crls-design/Flight-Controller/docs/schematic.pdf

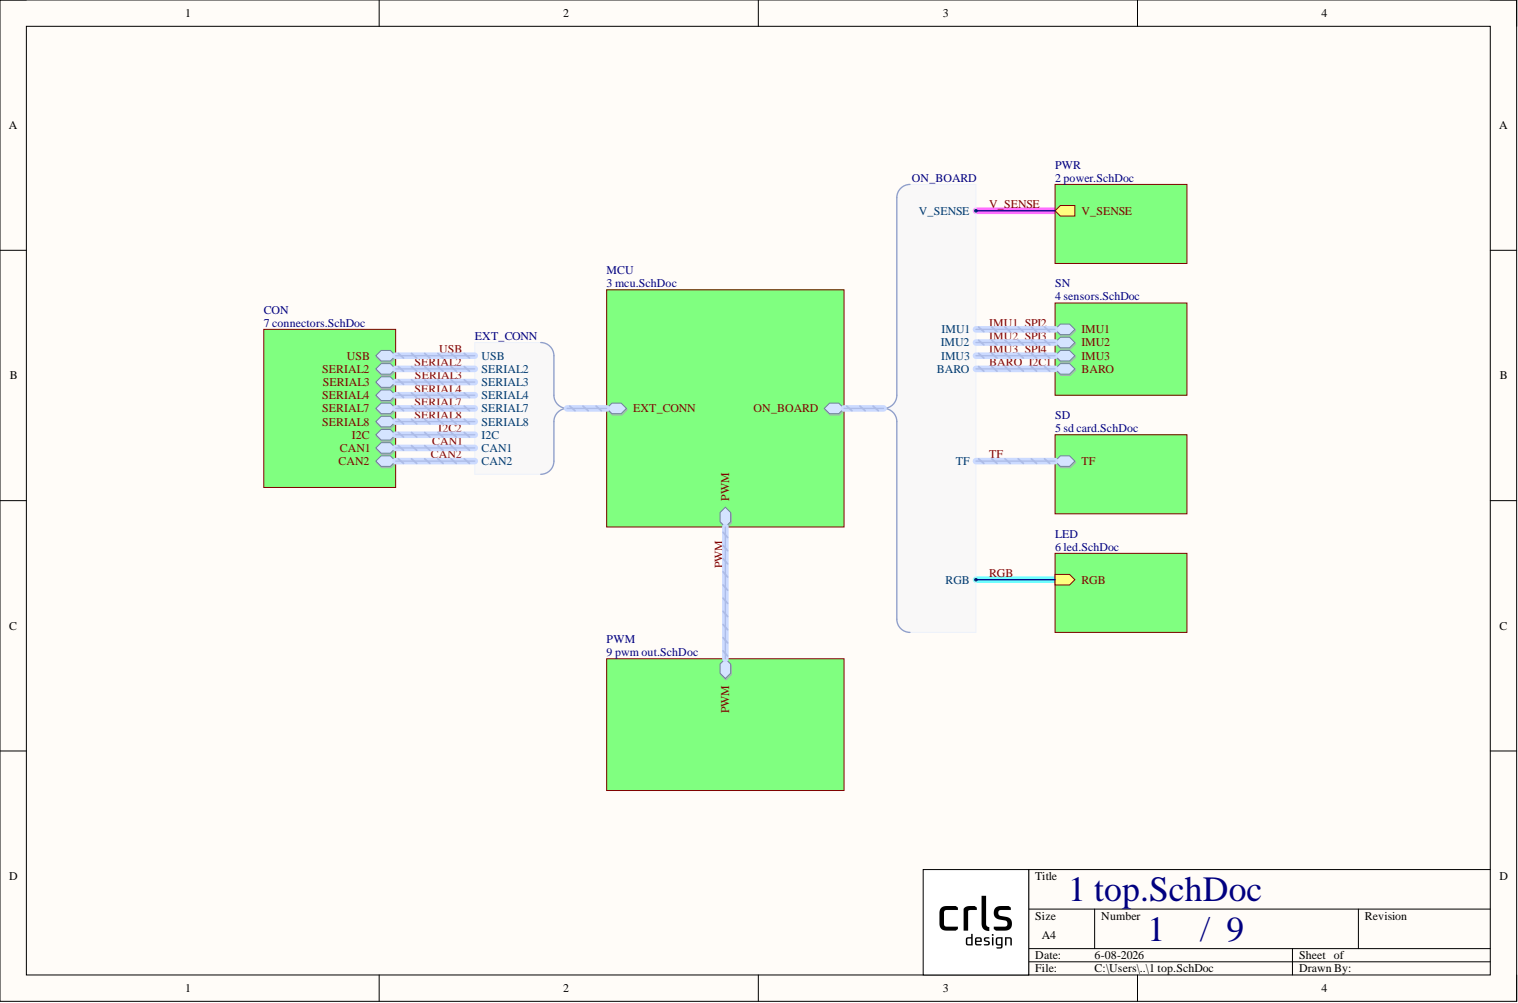
[picture p2: page 1]

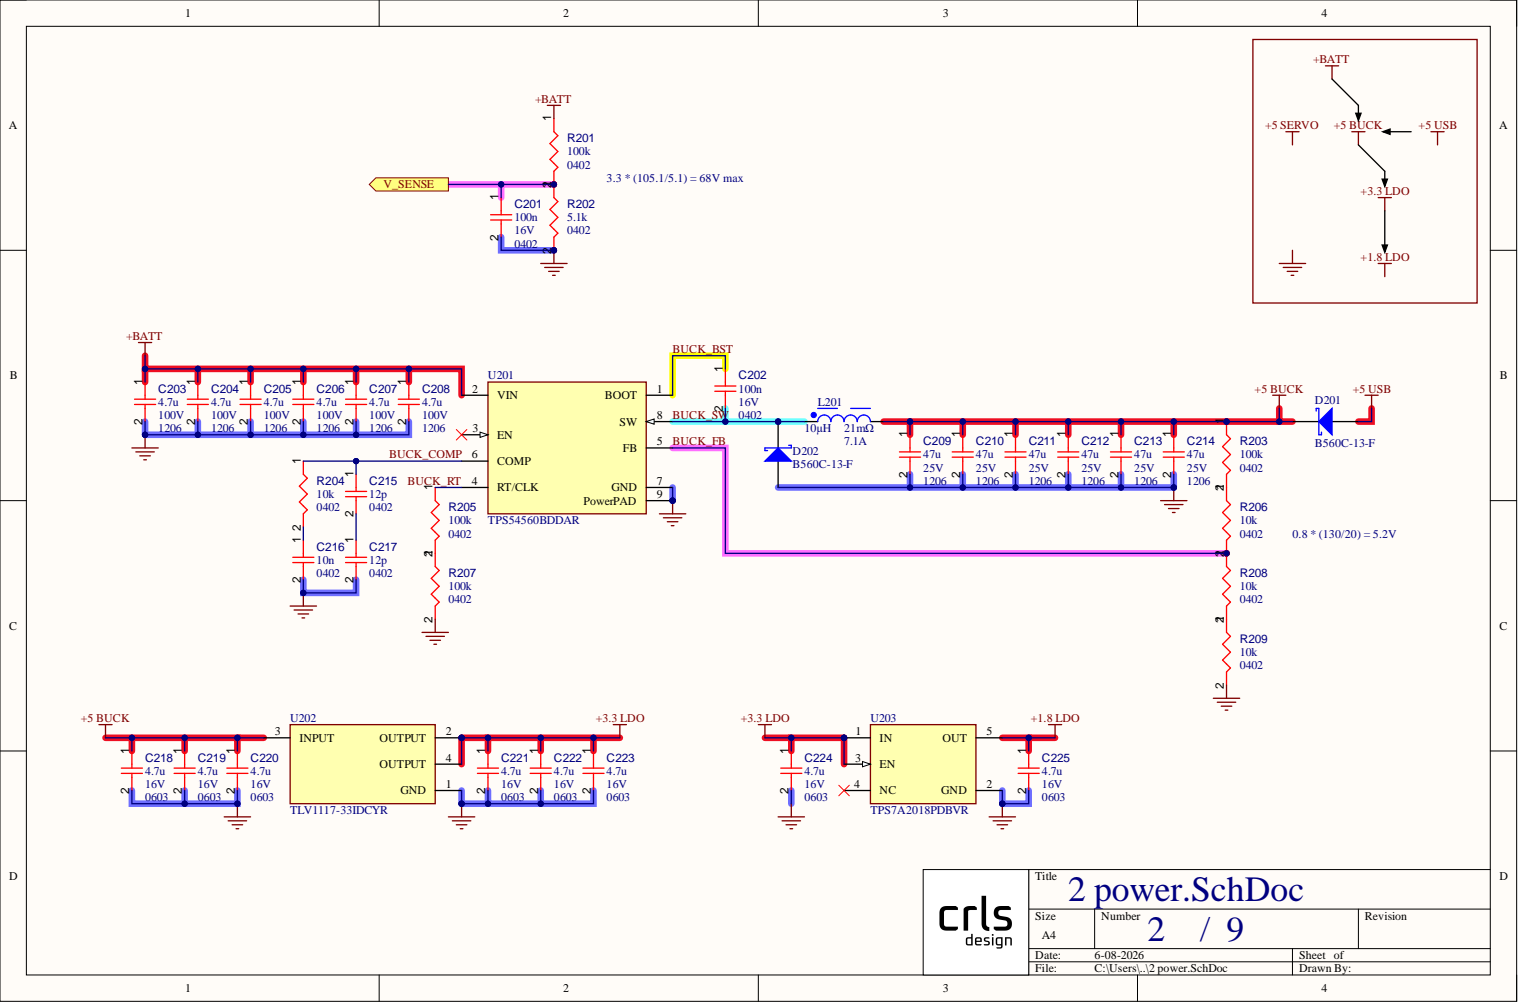
[picture p3: page 2]

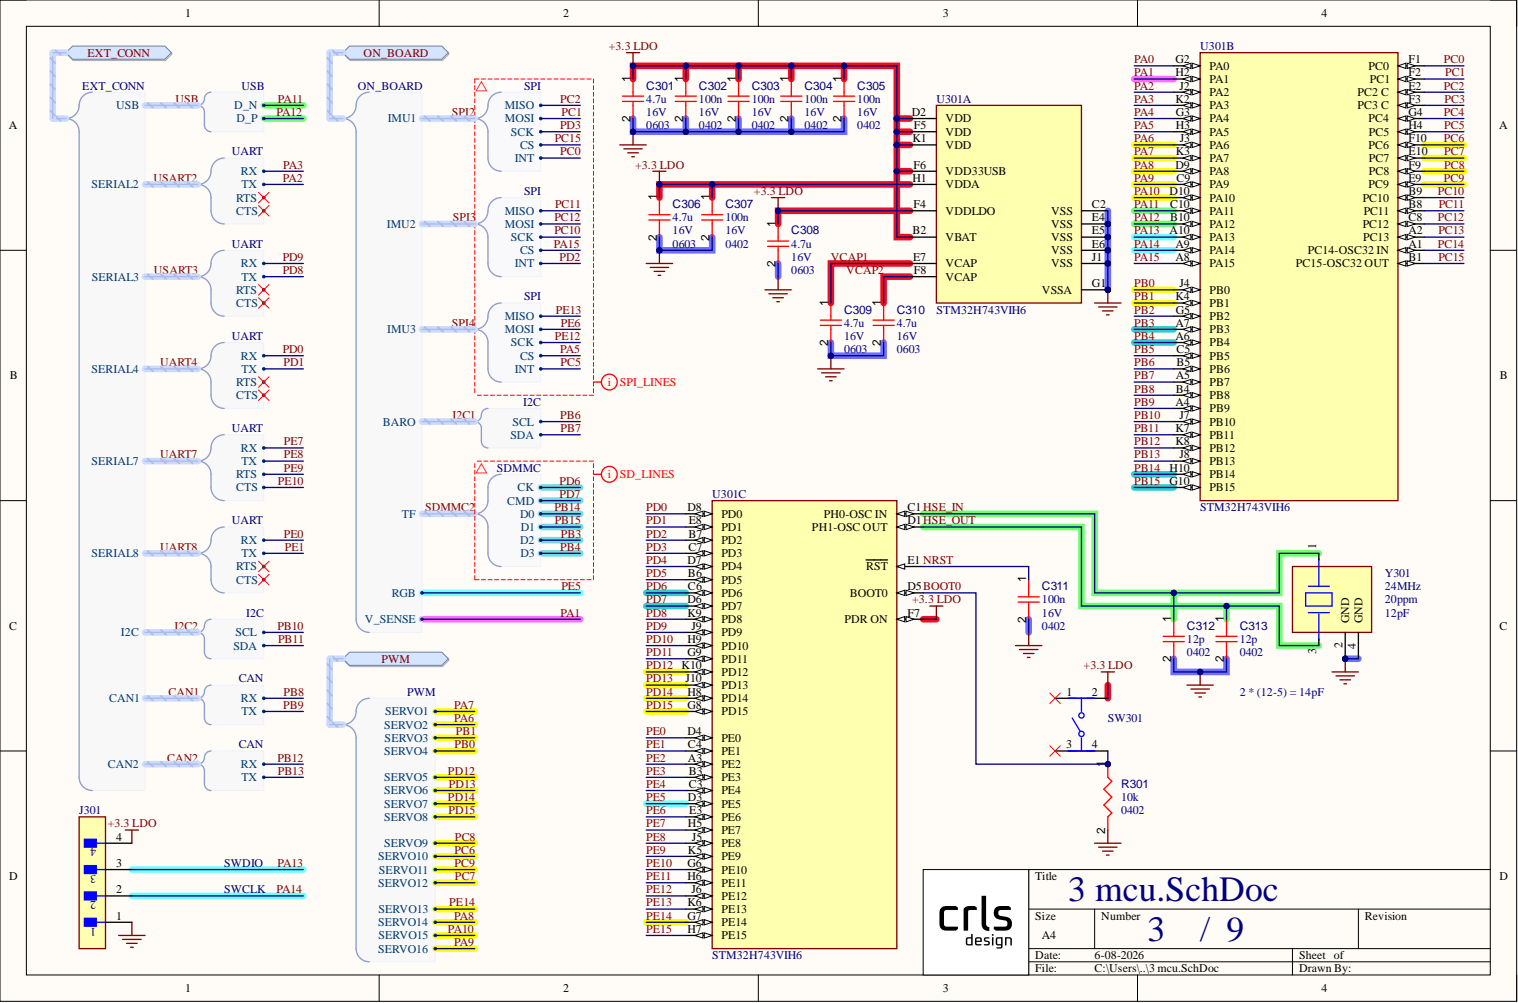
[picture p4: page 3]

V D D VDD D F5 V D B F6 3 3 U S VSS VSS A | PA 4 G 3

L D O | | VDD K1 | PA 6 J 3

+3.3 L D O | VDDA H1 VDDLDO F4 VCAP E7 VCAP F8 VBAT B2 | PA 1 0 D 1 0

C2 VSS E4 VSS E5 VSS E6 VSS J1 | PA 1 2

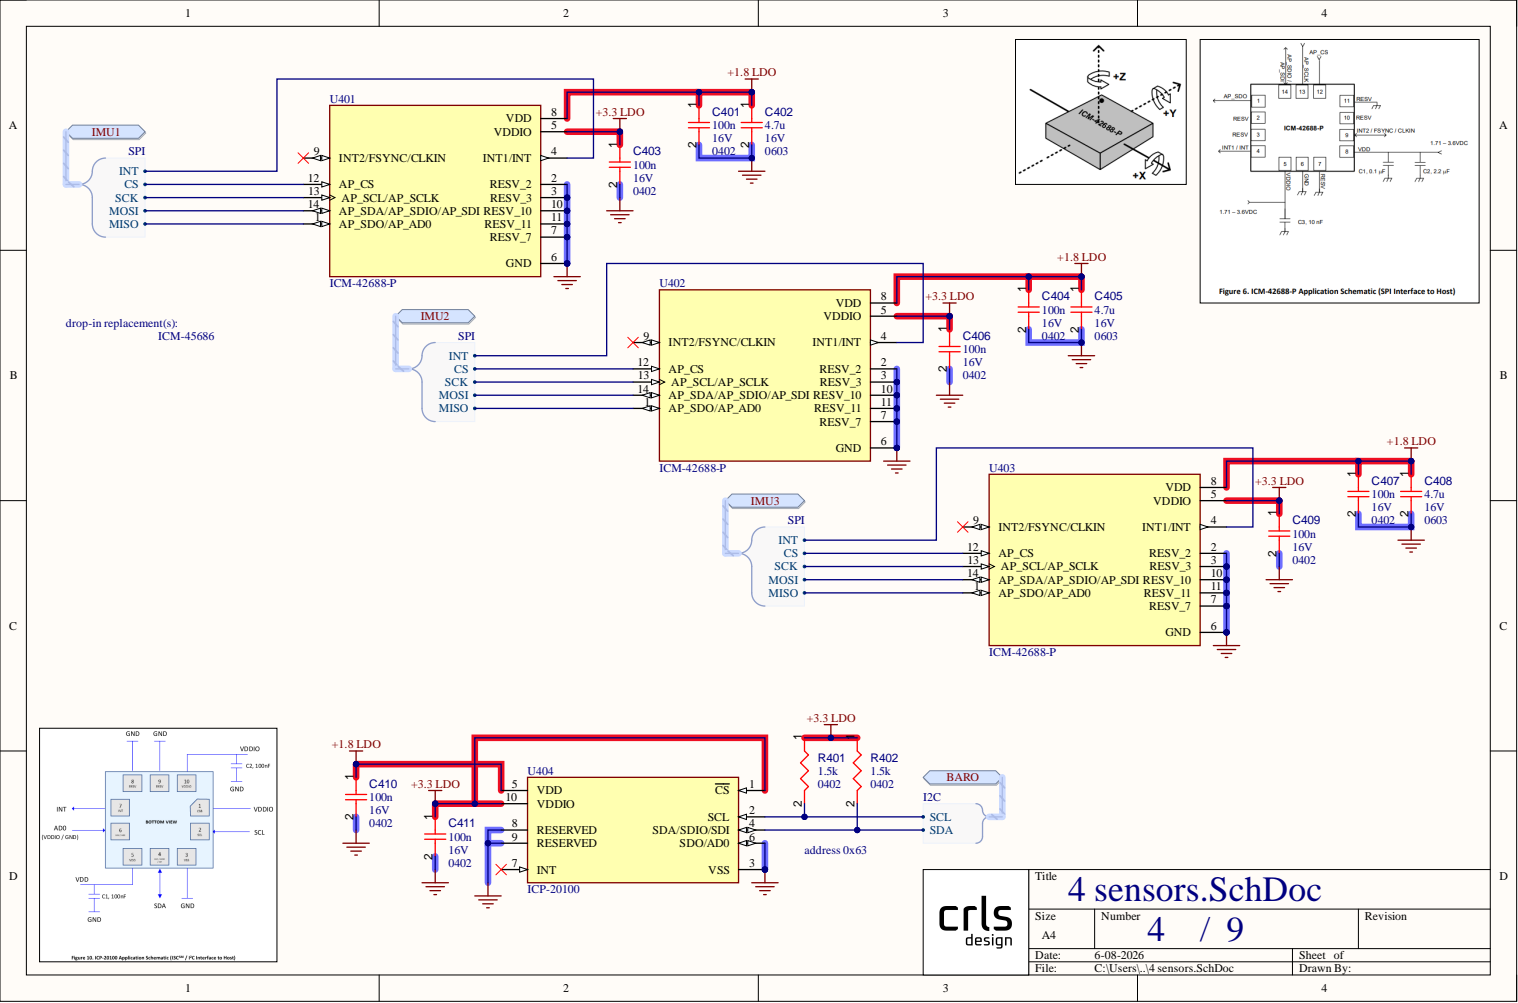
[picture p5: page 4]

VDDIO 10

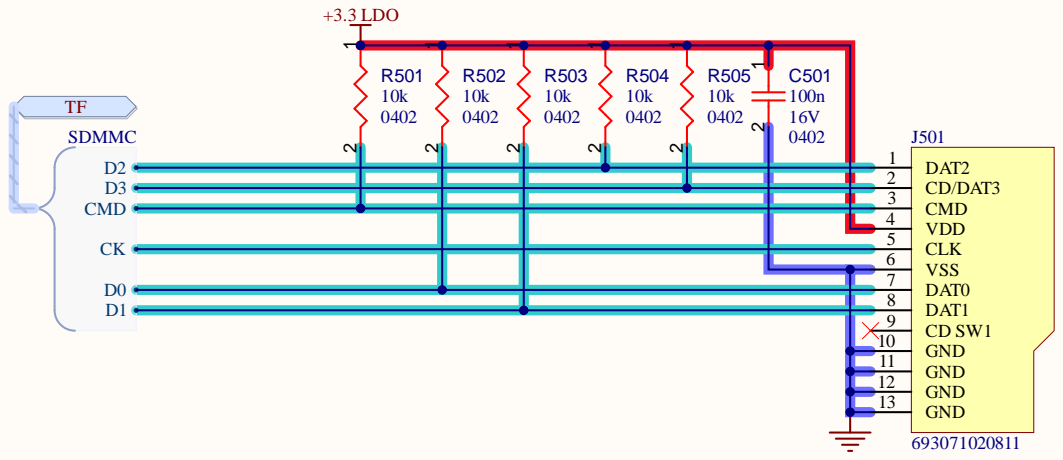
[picture p6: page 5]

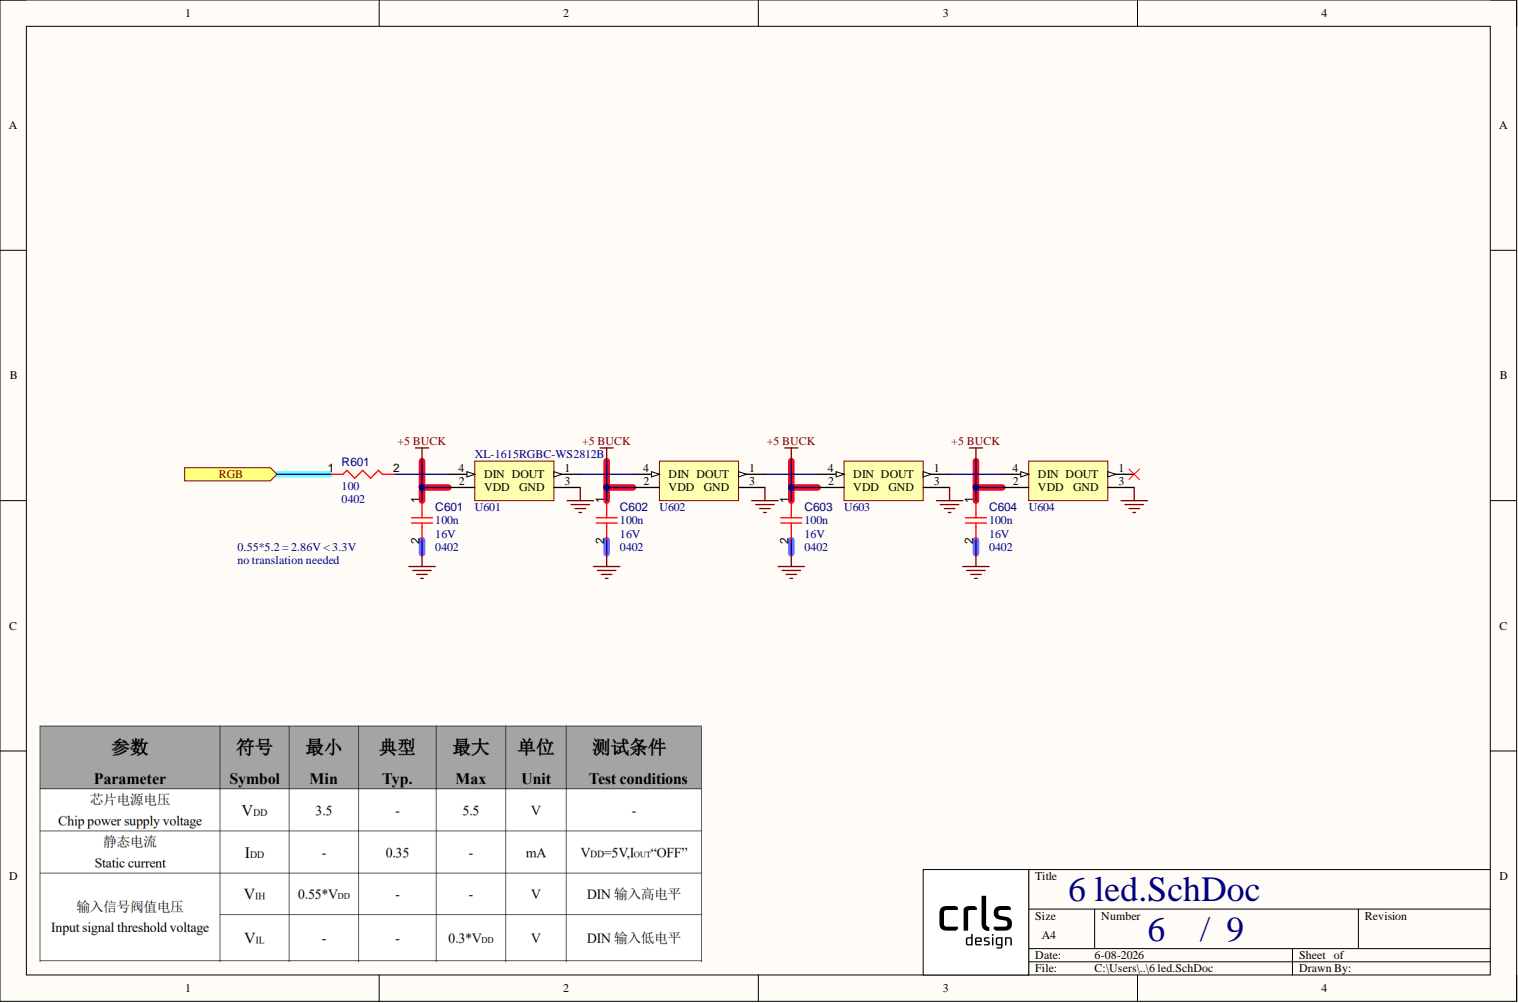
[picture p7: page 6]

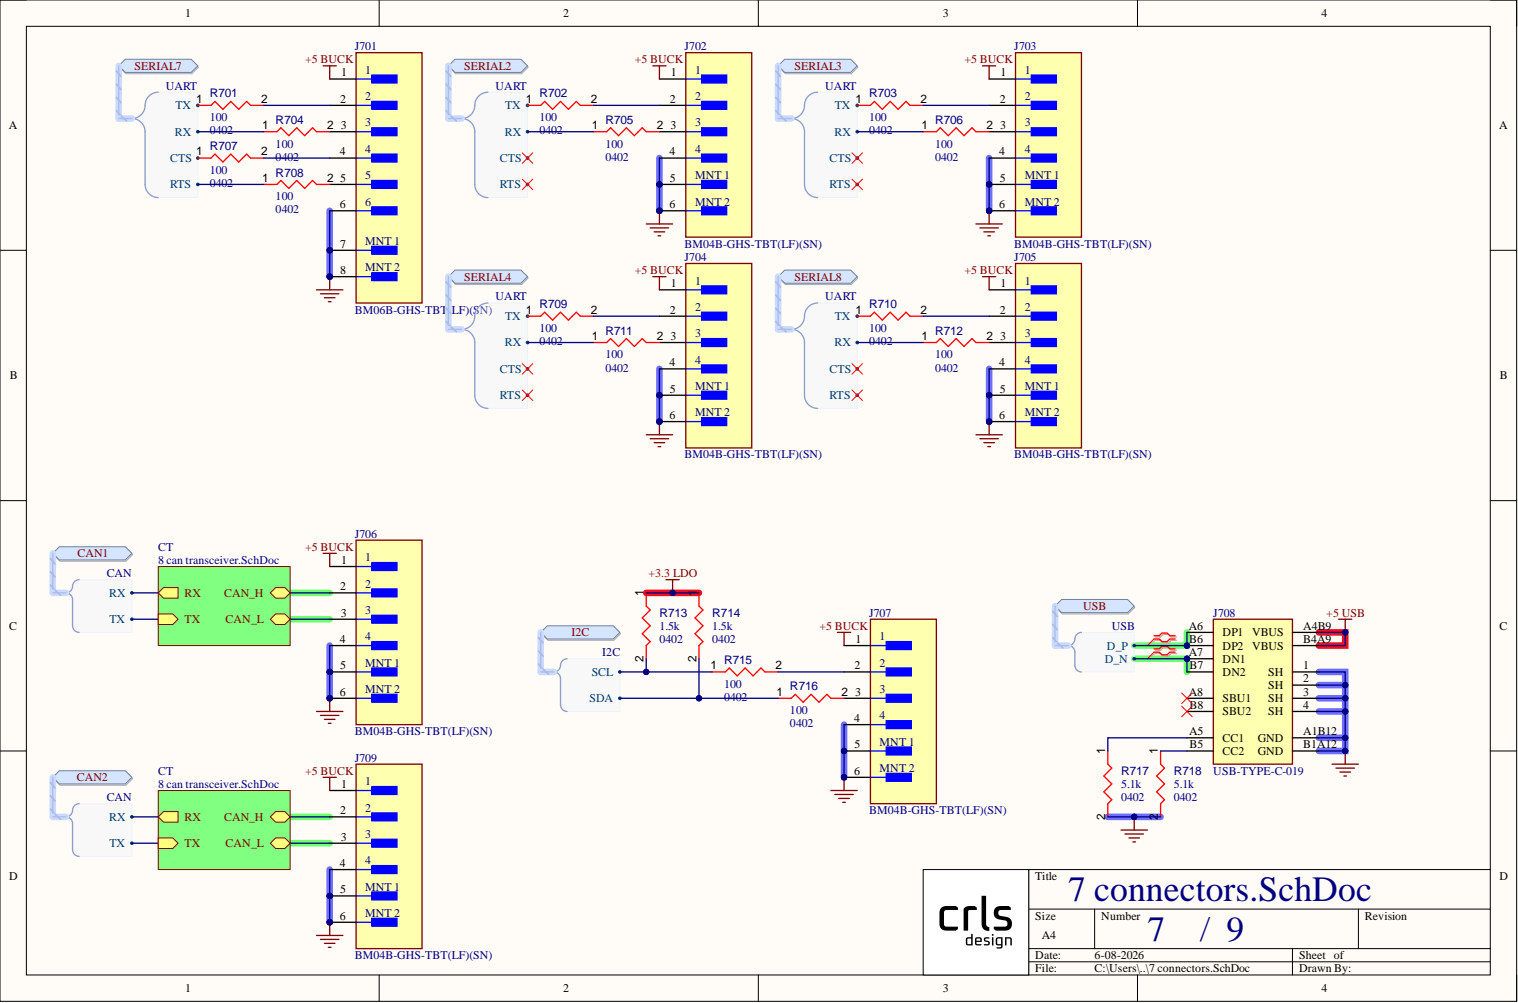
[picture p8: page 7]

BM04B-GHS-TBT(LF)(SN)

BM06B-GHS-TBT(LF)(SN)

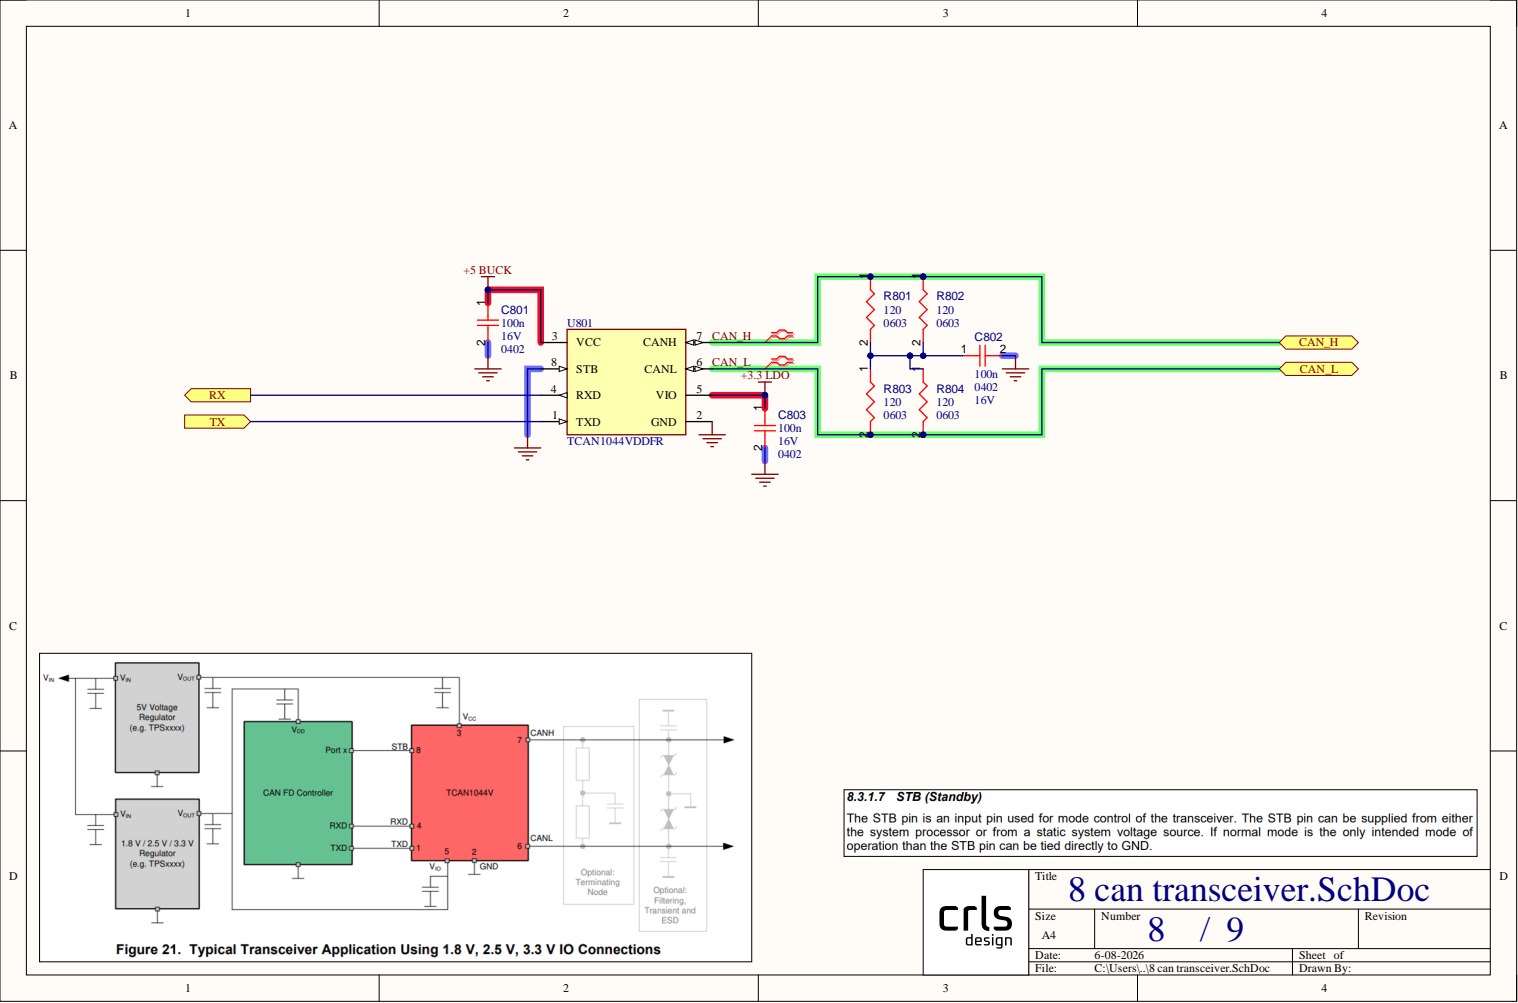
[picture p9: page 8]

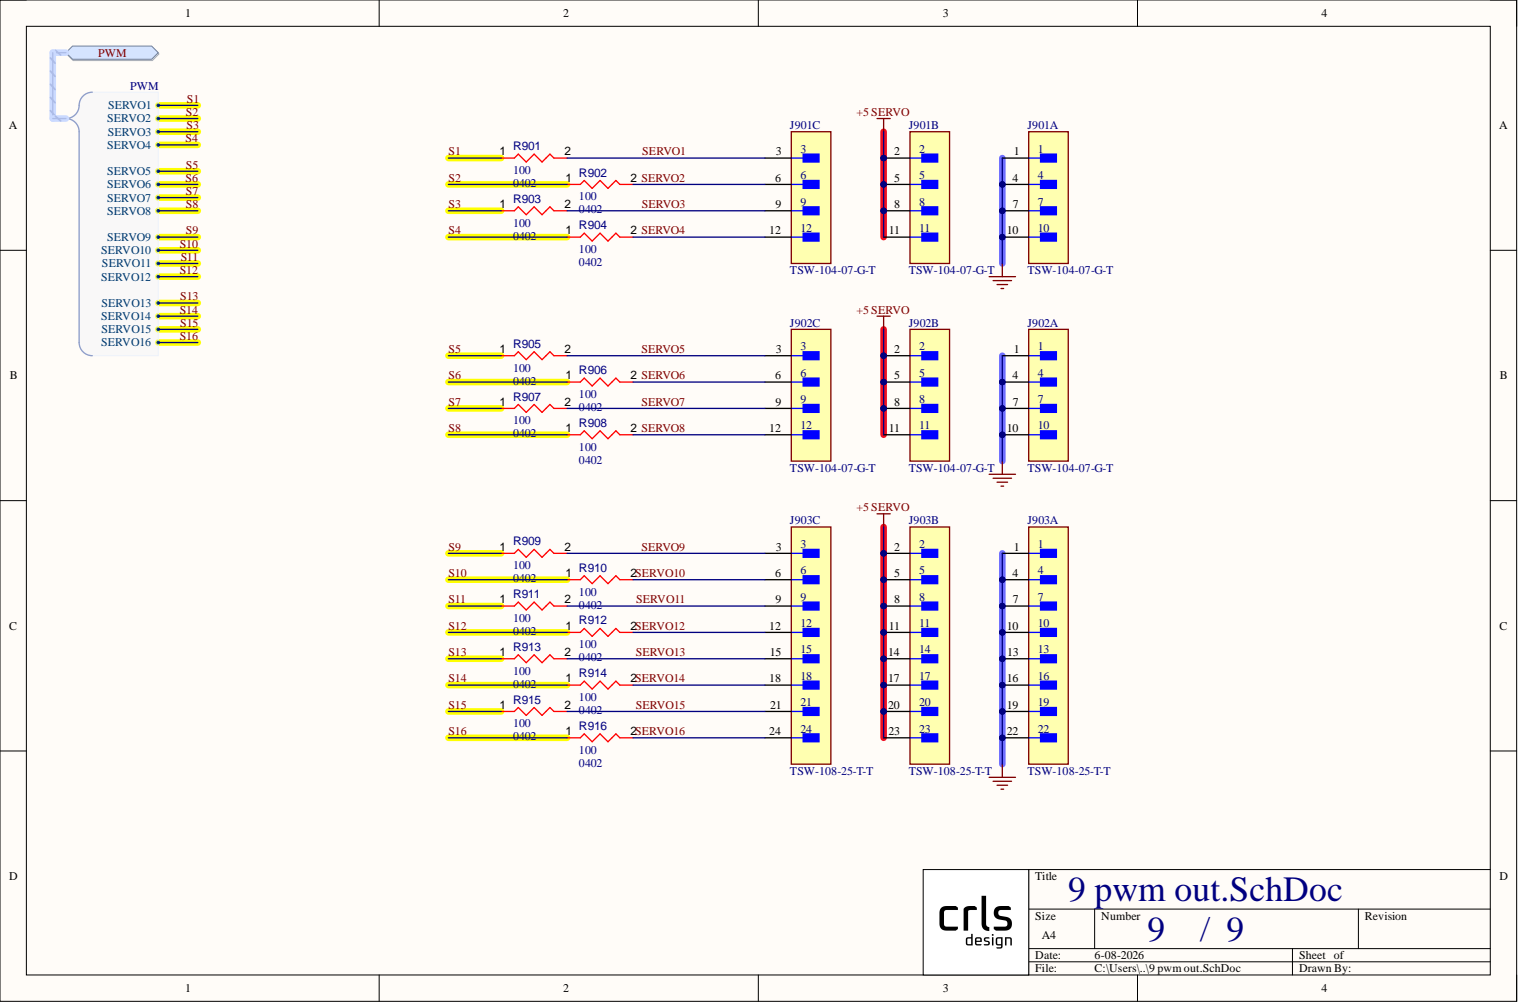
[picture p10: page 9]
