crls-design/Flight-Controller/(list of files, drawings)

Other design files:
hardware/h743/1 top.SchDoc
hardware/h743/2 power.SchDoc
hardware/h743/3 mcu.SchDoc
hardware/h743/4 sensors.SchDoc
hardware/h743/5 sd card.SchDoc
hardware/h743/6 led.SchDoc
hardware/h743/7 connectors.SchDoc
hardware/h743/8 can transceiver.SchDoc
hardware/h743/9 pwm out.SchDoc
hardware/h743/Flight Controller.PrjPcb
hardware/h743/main.PcbDoc
hardware/h743/panel.PcbDoc
