crls-design/Flight-Controller/(commit log)

2025-09-28 add design files
    [1 top.SchDoc, 2 power.SchDoc, 3 mcu.SchDoc, 4 sensors.SchDoc, 5 sd card.SchDoc, 6 led.SchDoc, 7 connectors.SchDoc, 8 can transceiver.SchDoc]
2025-10-05 remove unconnected inner annular ring
    [main.PcbDoc]
2025-10-05 add ardupilot hwdef
    [defaults.parm]
2026-06-08 add schematic print
