crls-design/Flight-Controller/(notices)

Notices in the files:
firmware/betaflight/src/config/configs/CRLSH743/config.h:
Public License as published by the Free Software Foundation,
either version 3 of the License, or (at your option) any later
